frank26080115/Bones-3D-Printer/cad_exports/STL/Gcode_Hephaestus/readme.txt

These G-code files only work on my (Frank's) Hephaestus 3D printer
