frank26080115/Bones-3D-Printer/images/corexy/beltfrm3.png

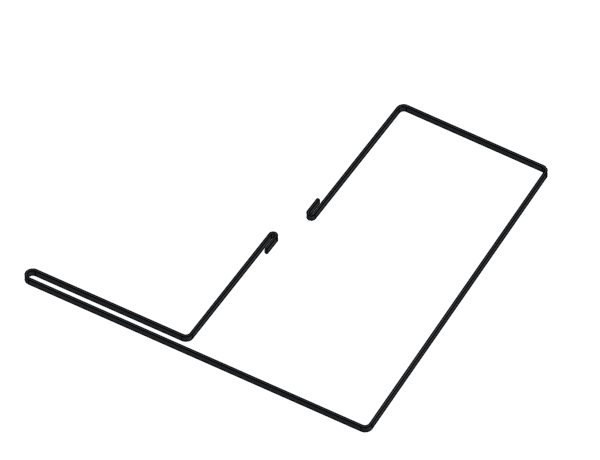
images/corexy/beltfrm3.png
