frank26080115/Bones-3D-Printer/images/corexydesignreview1.png

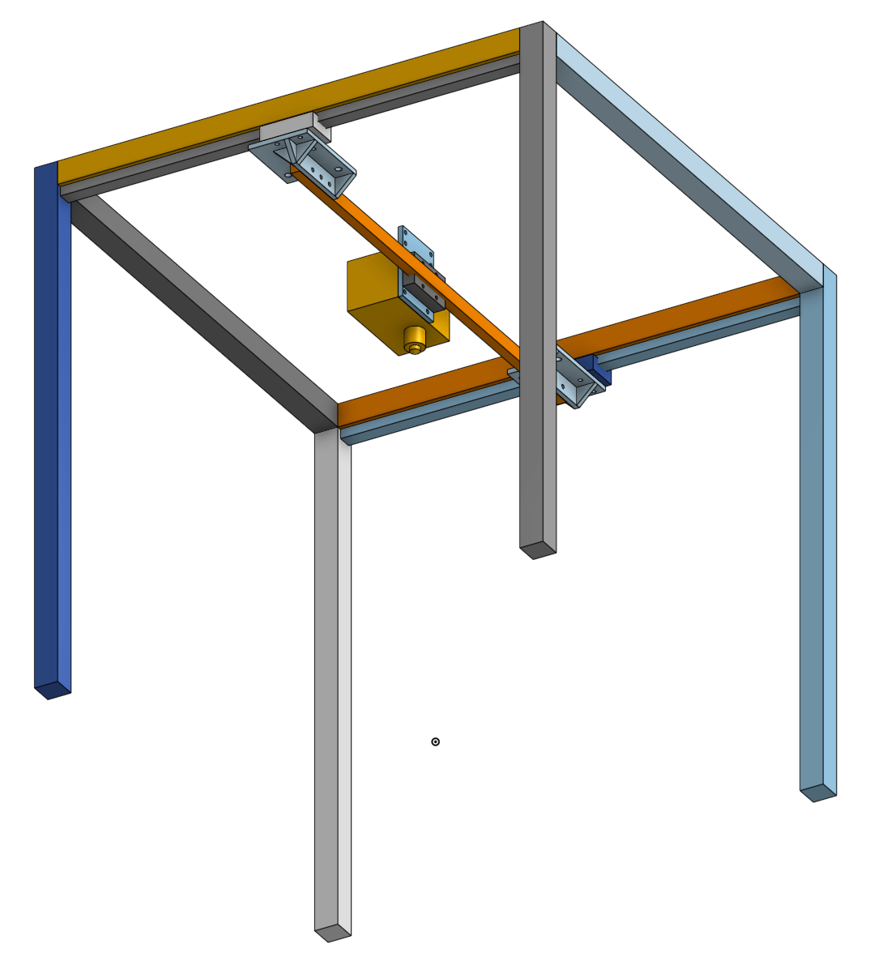
images/corexydesignreview1.png
