frank26080115/Bones-3D-Printer/images/lesson1/hbeamfrontrearmirror.png

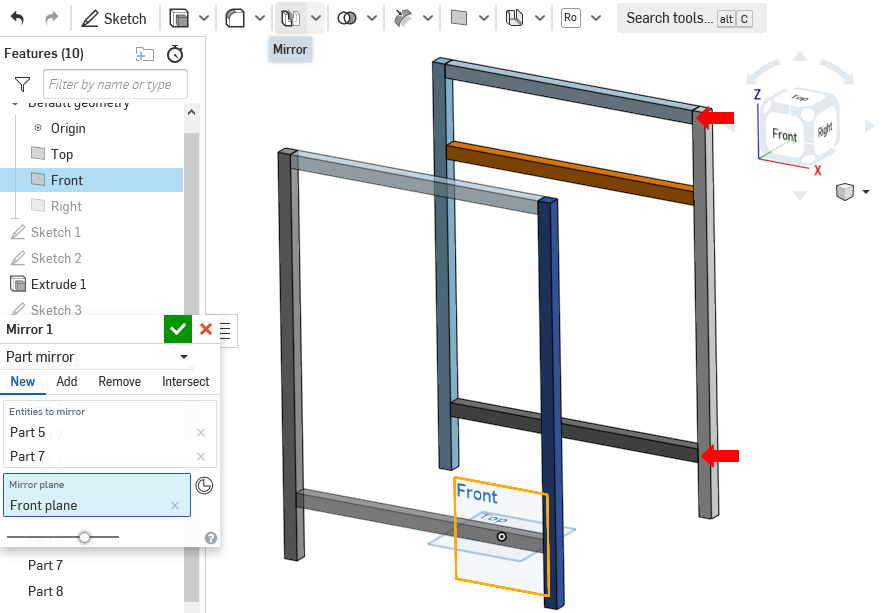
images/lesson1/hbeamfrontrearmirror.png
