frank26080115/Bones-3D-Printer/images/lesson1/zupperplanningsketches.png

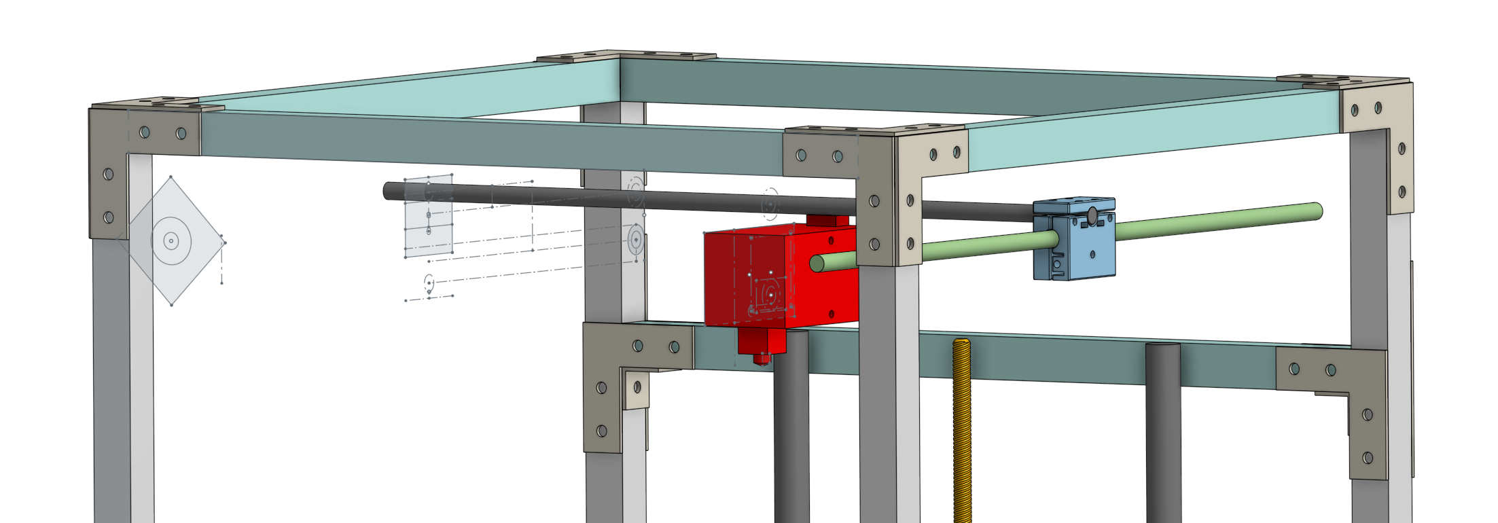
images/lesson1/zupperplanningsketches.png
