frank26080115/Bones-3D-Printer/images/lesson3/wobbleani1.png

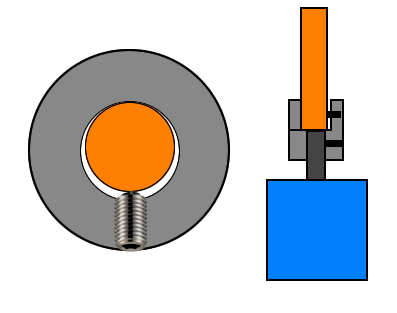
images/lesson3/wobbleani1.png
