frank26080115/Bones-3D-Printer/images/lesson5/pictures/toothedbelt.jpg

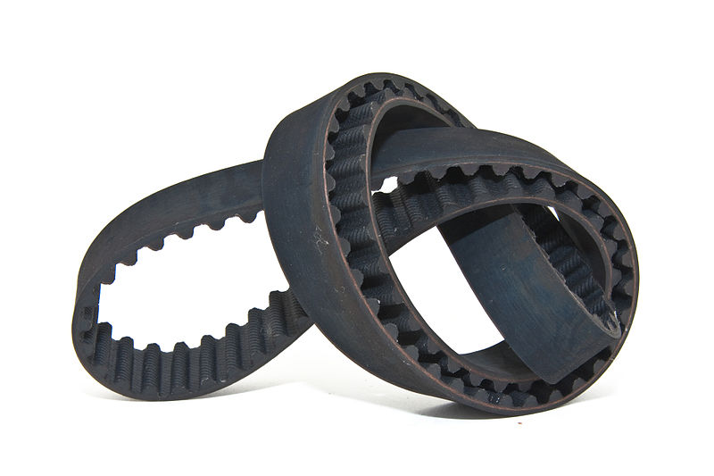
images/lesson5/pictures/toothedbelt.jpg
