frank26080115/Bones-3D-Printer/images/lesson6/powersupplyvariations.png

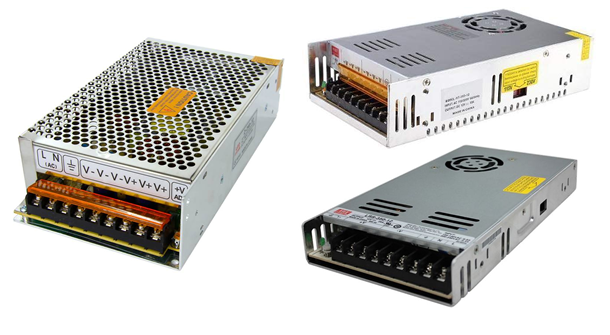
images/lesson6/powersupplyvariations.png
