frank26080115/Bones-3D-Printer/images/lesson10/extrudermountanimation/1.png

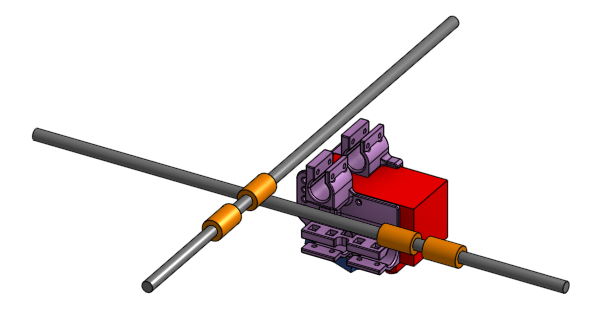
images/lesson10/extrudermountanimation/1.png
