frank26080115/Bones-3D-Printer/images/lesson10/extrudermountanimation/3.png

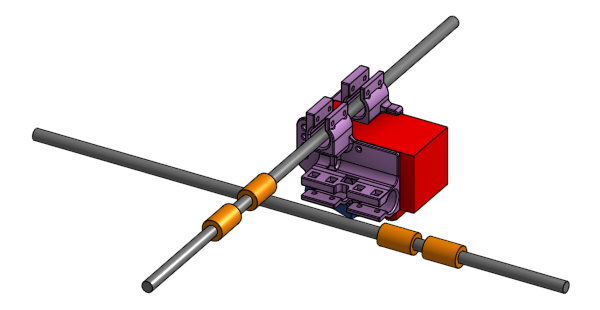
images/lesson10/extrudermountanimation/3.png
