frank26080115/Bones-3D-Printer/images/lesson10/rodsmoveanimation/2.png

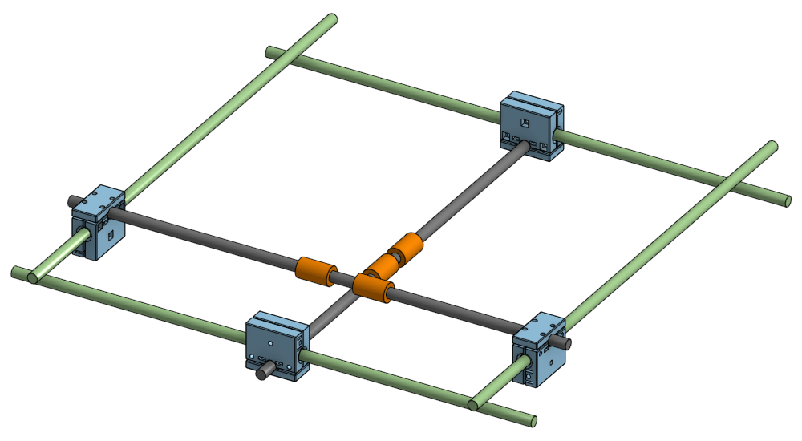
images/lesson10/rodsmoveanimation/2.png
