frank26080115/Bones-3D-Printer/images/lesson10/zaxistightenanimation/up.png

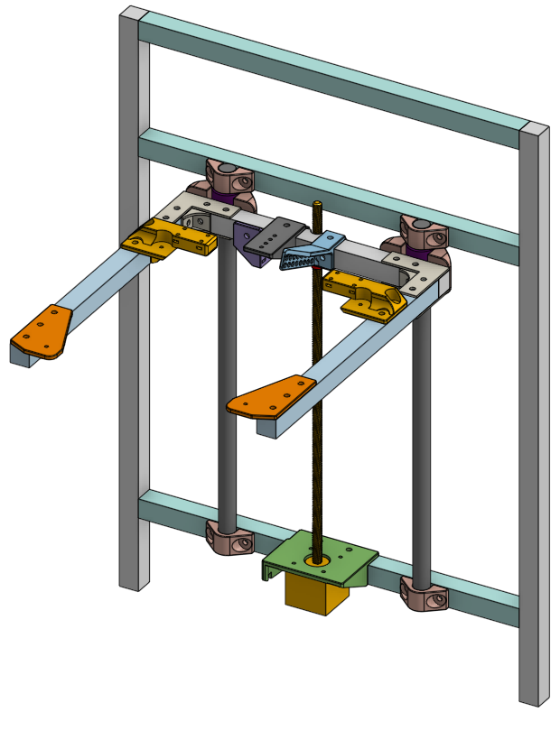
images/lesson10/zaxistightenanimation/up.png
