frank26080115/Bones-3D-Printer/images/lesson11/connectfansferrule.png

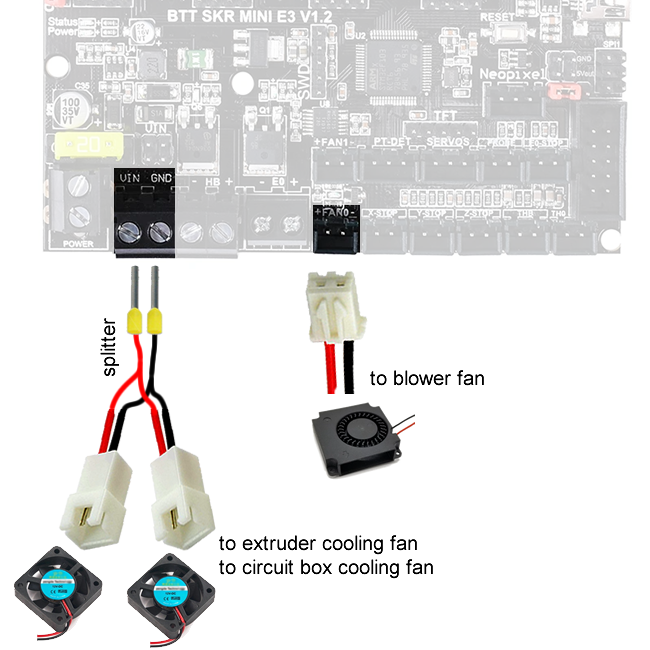
images/lesson11/connectfansferrule.png
