frank26080115/Bones-3D-Printer/images/lesson11/extruderfanextensionwireferrule.png

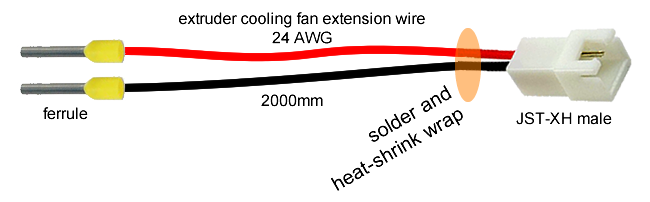
images/lesson11/extruderfanextensionwireferrule.png
