frank26080115/Bones-3D-Printer/images/lesson11/fansplitterferrule.png

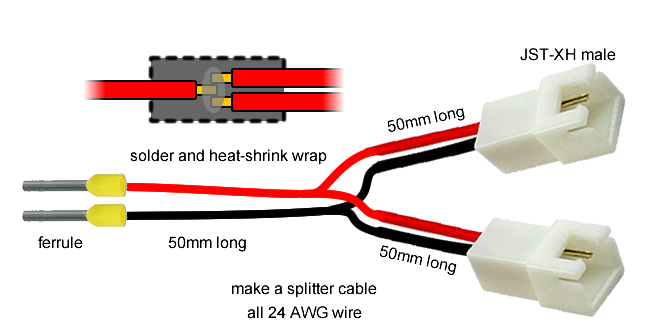
images/lesson11/fansplitterferrule.png
