frank26080115/Bones-3D-Printer/images/lesson12/fwupdateled1.png

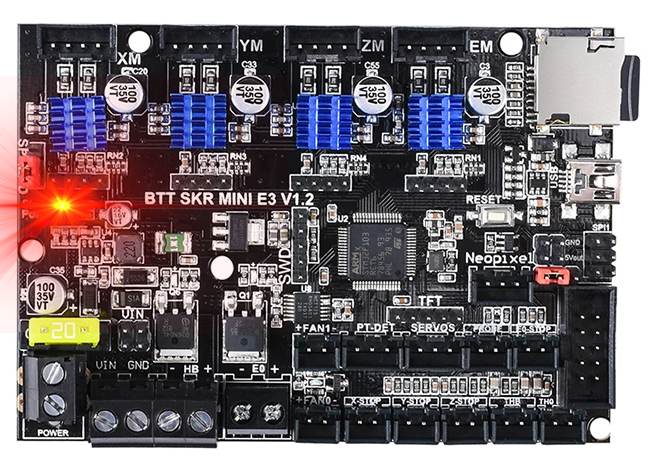
images/lesson12/fwupdateled1.png
