frank26080115/Bones-3D-Printer/images/other/freeleadscrew2.png

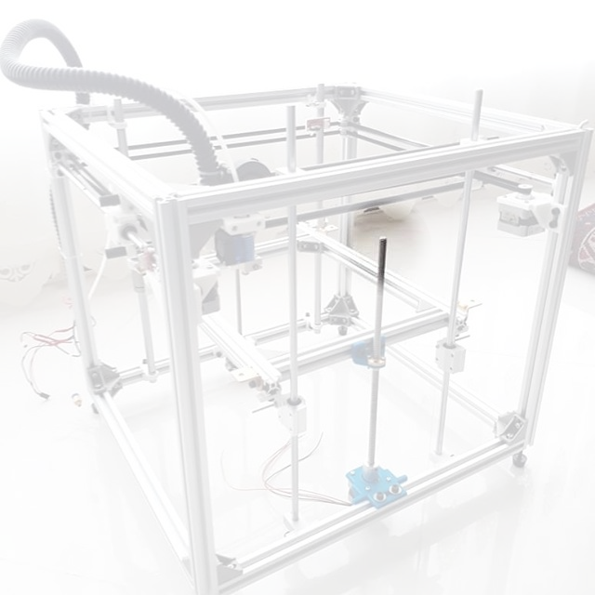
images/other/freeleadscrew2.png
