frank26080115/Bones-3D-Printer/cad_exports/Better Blower Fan Mount.step

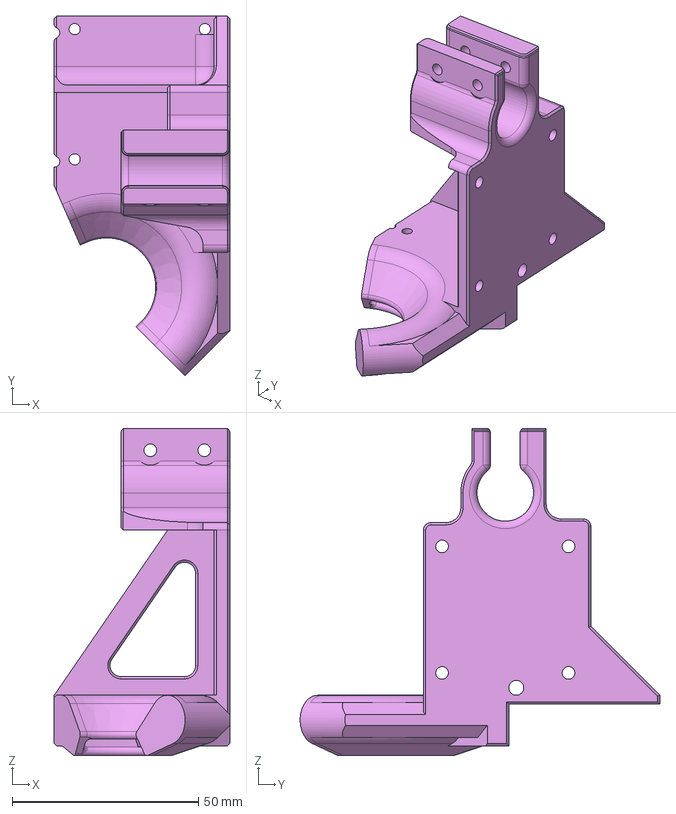
[picture p233: CAD file, 2020-03-14]
cad_exports/Better Blower Fan Mount.step
47.2 x 96.7 x 87.9 mm
