frank26080115/Bones-3D-Printer/cad_exports/STL/slidingblockouter.stl

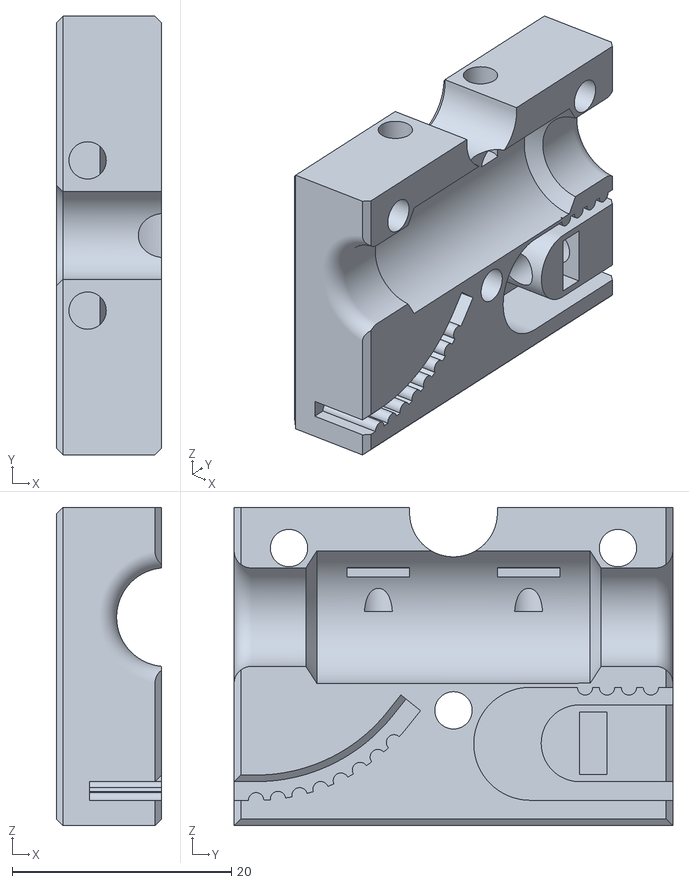
[picture p234: CAD file, 2020-03-14]
cad_exports/STL/slidingblockouter.stl
9.60 x 40.0 x 29.0
