frank26080115/Bones-3D-Printer/cad_exports/STL/psushield.stl

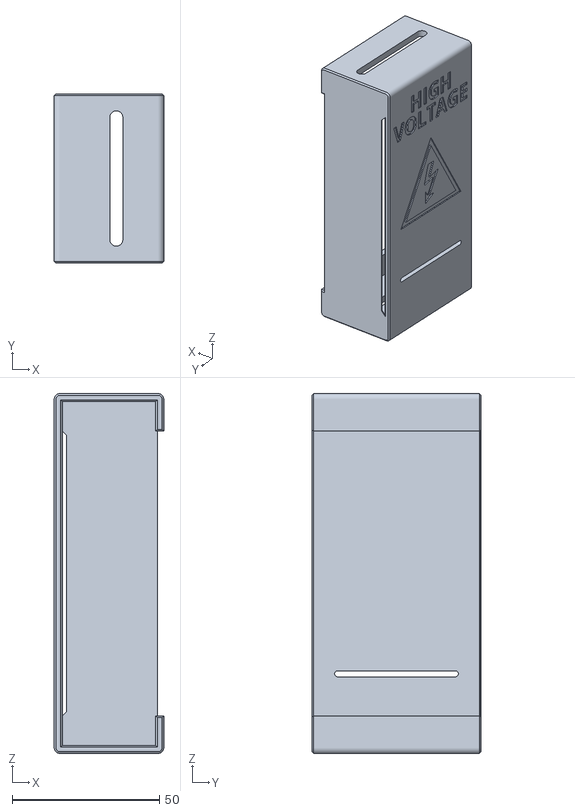
[picture p235: CAD file, 2020-03-14]
cad_exports/STL/psushield.stl
37.2 x 57.5 x 122.2
