frank26080115/Bones-3D-Printer/cad_exports/TFT24 Box Angled.step

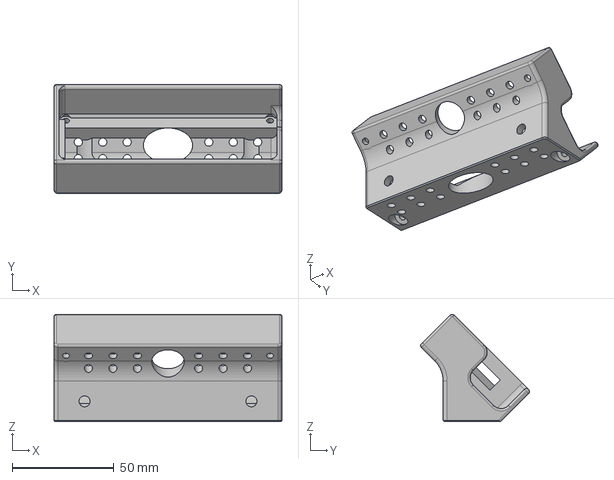
[picture p236: CAD file, 2020-03-07]
cad_exports/TFT24 Box Angled.step
111.8 x 53.4 x 52.7 mm
