frank26080115/Bones-3D-Printer/cad_exports/STL/circuitboxlid.stl

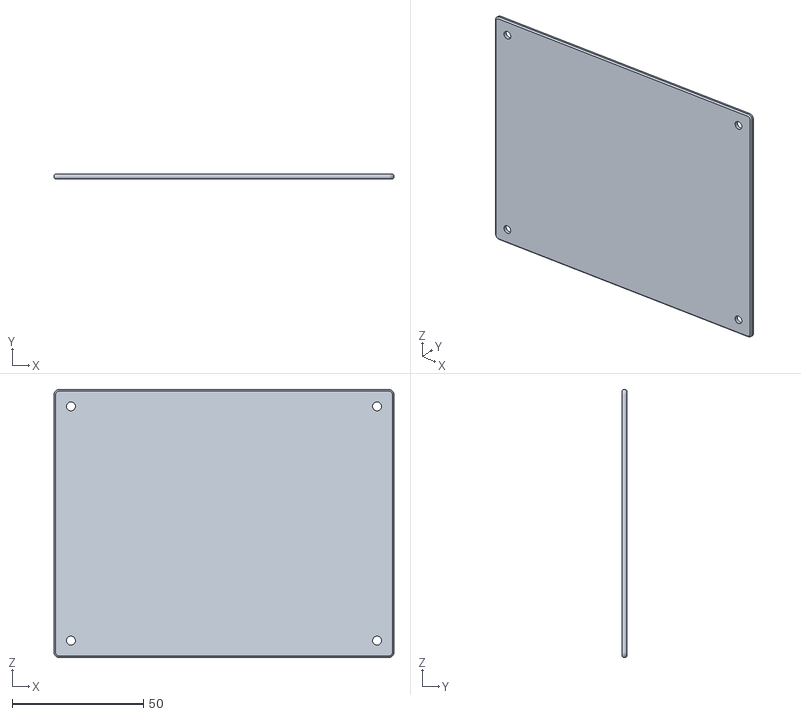
[picture p237: CAD file, 2020-03-14]
cad_exports/STL/circuitboxlid.stl
129.4 x 2.00 x 102.0
