frank26080115/Bones-3D-Printer/cad_exports/STL/box_bbtskrminie3.stl

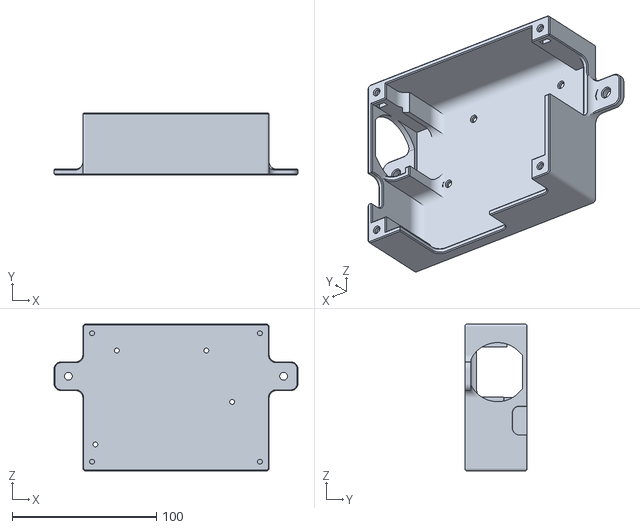
[picture p238: CAD file, 2020-03-14]
cad_exports/STL/box_bbtskrminie3.stl
169.4 x 42.8 x 102.0
