frank26080115/Bones-3D-Printer/cad_exports/STL/gantrybearingmnt_rearleft_xminlimit.stl

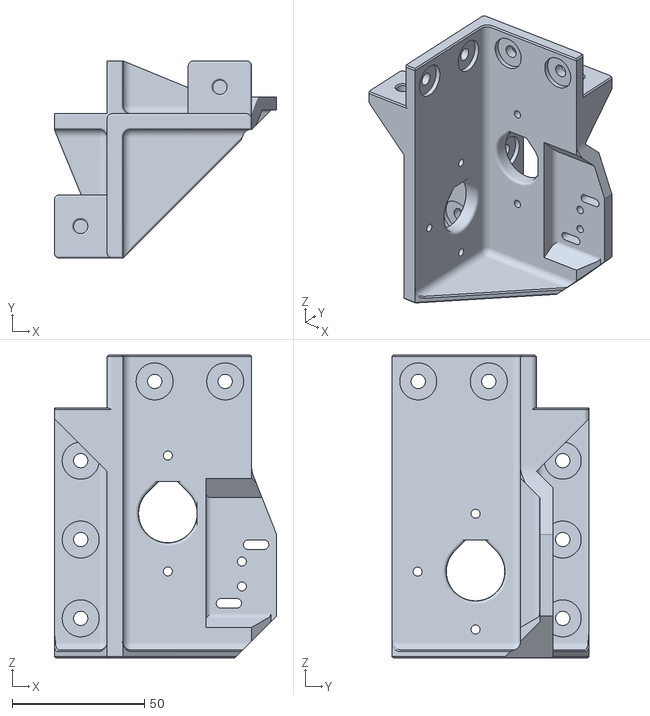
[picture p239: CAD file, 2020-03-14]
cad_exports/STL/gantrybearingmnt_rearleft_xminlimit.stl
84.2 x 74.7 x 114.7
