frank26080115/Bones-3D-Printer/cad_exports/STL/gantrybearingmnt_rearright.stl

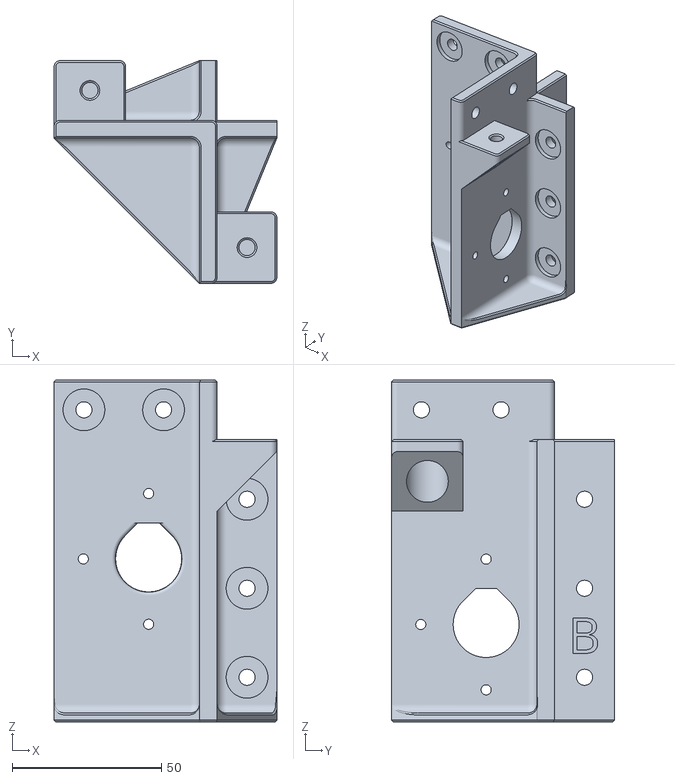
[picture p240: CAD file, 2020-03-14]
cad_exports/STL/gantrybearingmnt_rearright.stl
74.7 x 74.7 x 114.7
