frank26080115/Bones-3D-Printer/cad_exports/STL/gantrybearingmnt_frontleft_yminlimit.stl

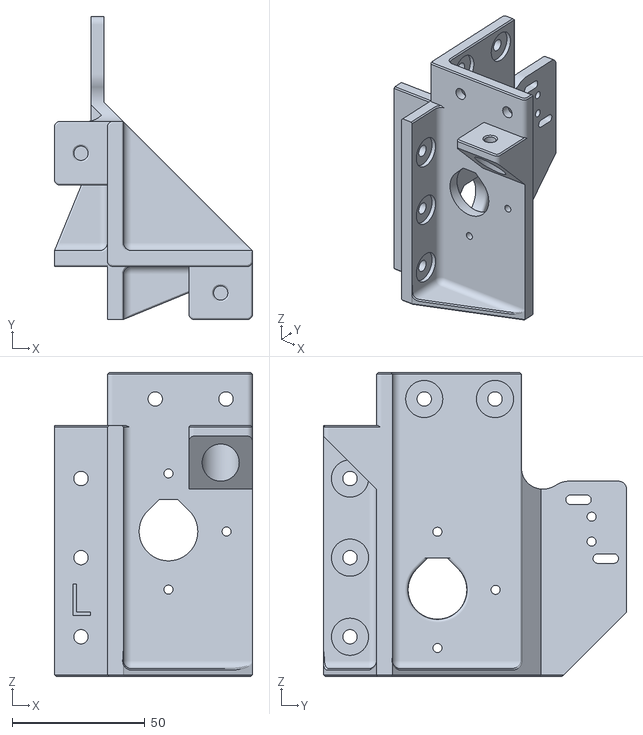
[picture p241: CAD file, 2020-03-14]
cad_exports/STL/gantrybearingmnt_frontleft_yminlimit.stl
74.7 x 114.3 x 114.7
