frank26080115/Bones-3D-Printer/cad_exports/STL/leadnutholder_cheaper.stl

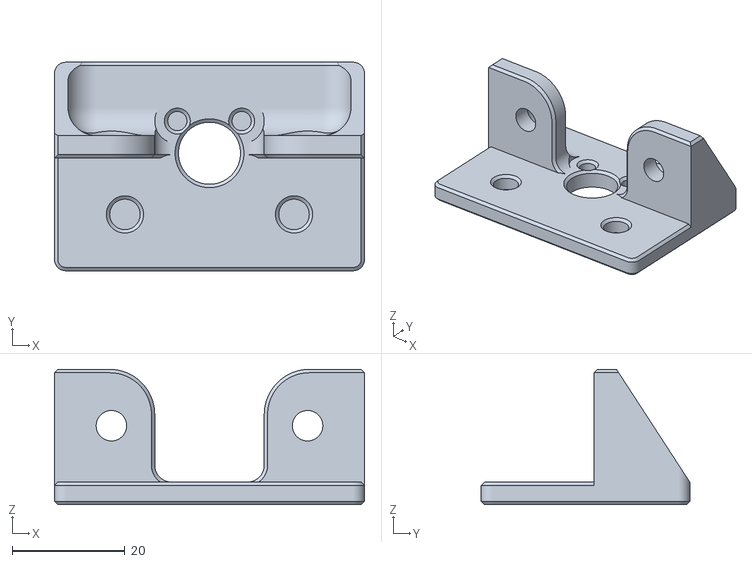
[picture p242: CAD file, 2020-03-08]
cad_exports/STL/leadnutholder_cheaper.stl
55.0 x 37.0 x 24.0
