frank26080115/Bones-3D-Printer/cad_exports/STL/acpwrpanel_4mmthick.stl

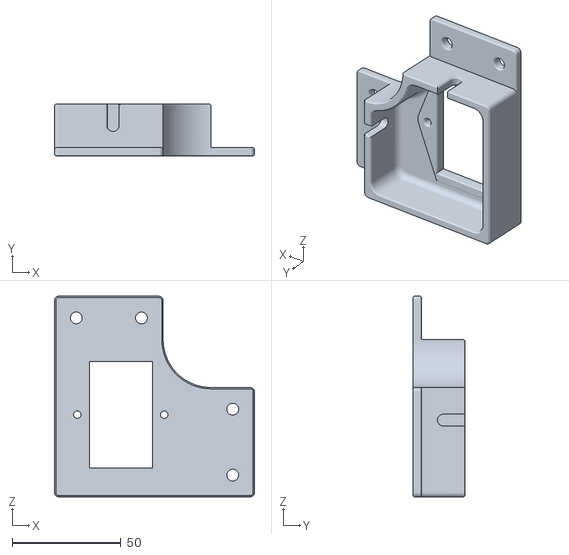
[picture p243: CAD file, 2020-03-08]
cad_exports/STL/acpwrpanel_4mmthick.stl
92.0 x 24.0 x 92.3
