frank26080115/Bones-3D-Printer/cad_exports/STL/slidingblockinner.stl

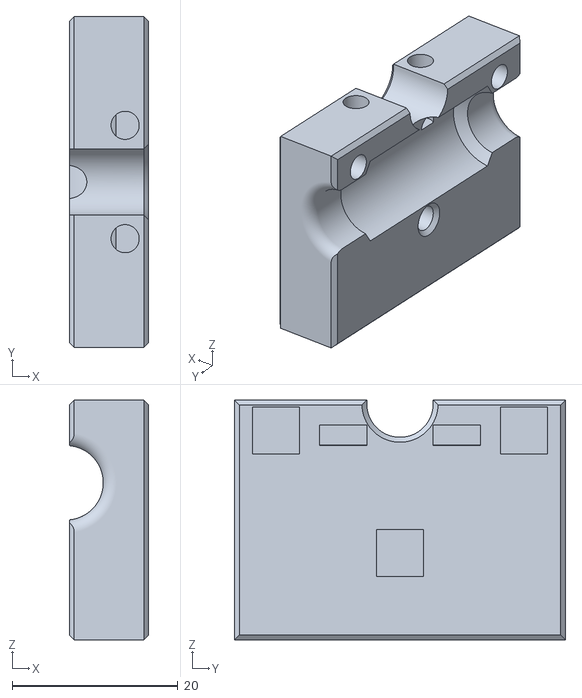
[picture p244: CAD file, 2020-03-08]
cad_exports/STL/slidingblockinner.stl
9.60 x 40.0 x 29.0
