frank26080115/Bones-3D-Printer/cad_exports/STL/zmotorholder.stl

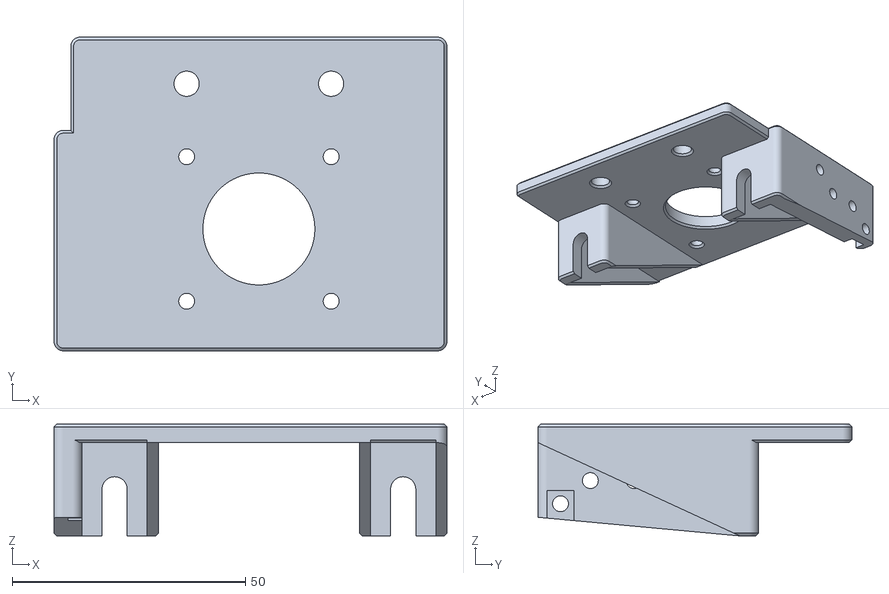
[picture p245: CAD file, 2020-03-07]
cad_exports/STL/zmotorholder.stl
84.3 x 67.3 x 24.0
