frank26080115/Bones-3D-Printer/cad_exports/STL/acpwrpanelshield.stl

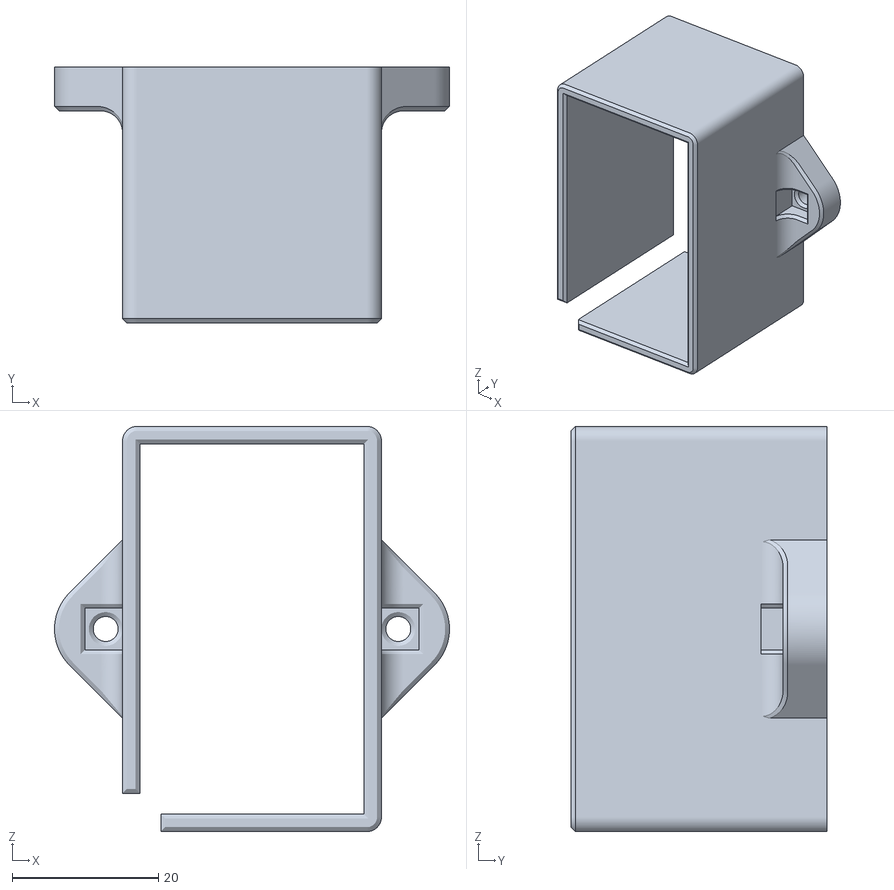
[picture p246: CAD file, 2020-03-07]
cad_exports/STL/acpwrpanelshield.stl
54.0 x 35.0 x 55.4
