frank26080115/Bones-3D-Printer/cad_exports/STL/bedcableanchor.stl

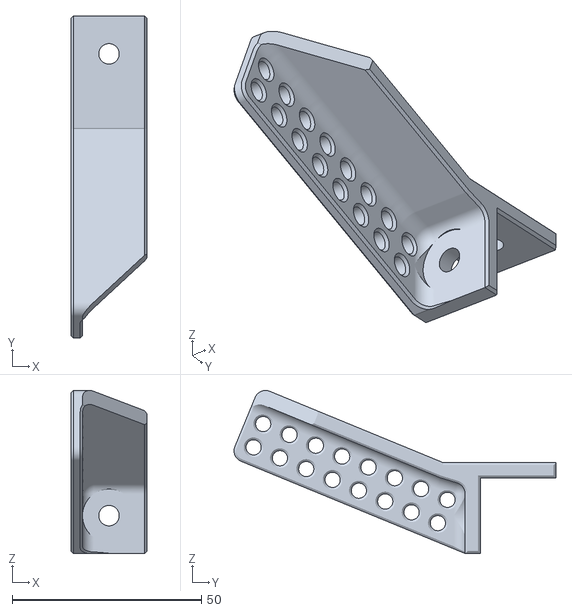
[picture p247: CAD file, 2020-03-07]
cad_exports/STL/bedcableanchor.stl
20.0 x 85.1 x 43.1
