frank26080115/Bones-3D-Printer/cad_exports/STL/acpwrpanel_2mmthick.stl

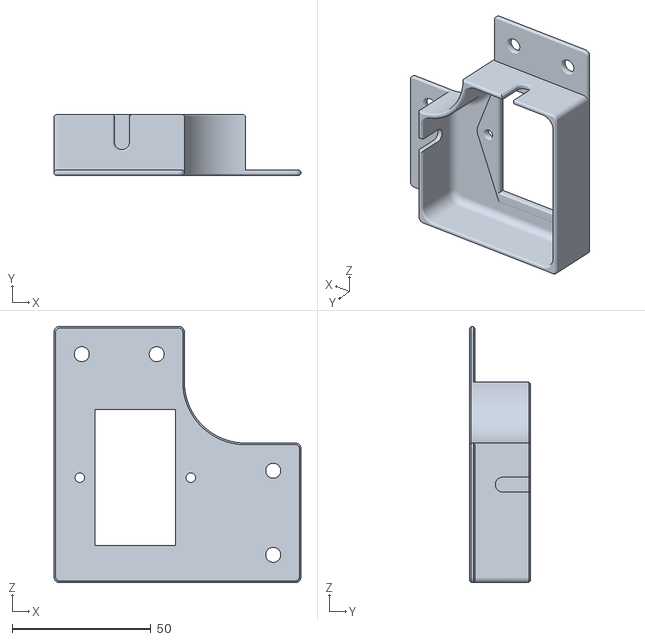
[picture p248: CAD file, 2020-03-07]
cad_exports/STL/acpwrpanel_2mmthick.stl
89.0 x 22.0 x 92.3
