frank26080115/Bones-3D-Printer/cad_exports/STL/bedstand_rearright_16mmtall.stl

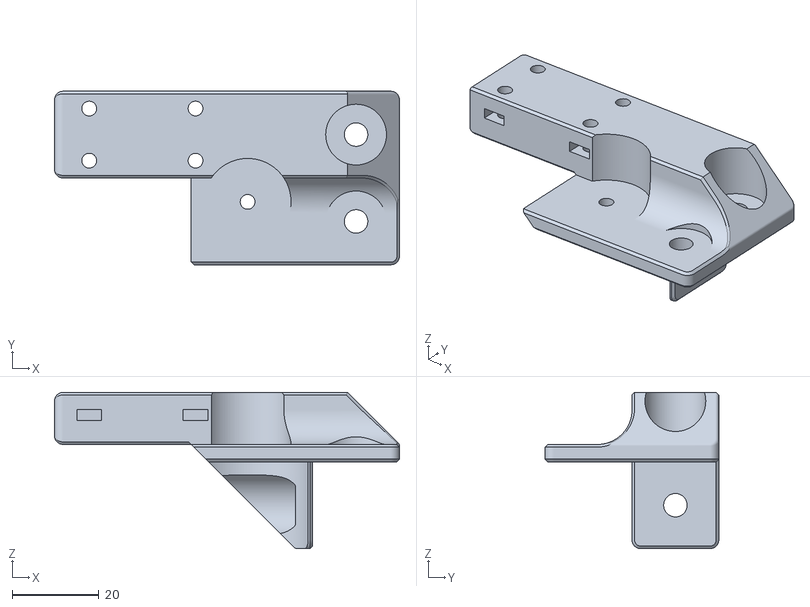
[picture p249: CAD file, 2020-03-07]
cad_exports/STL/bedstand_rearright_16mmtall.stl
79.5 x 40.0 x 36.0
