frank26080115/Bones-3D-Printer/cad_exports/STL/psumount.stl

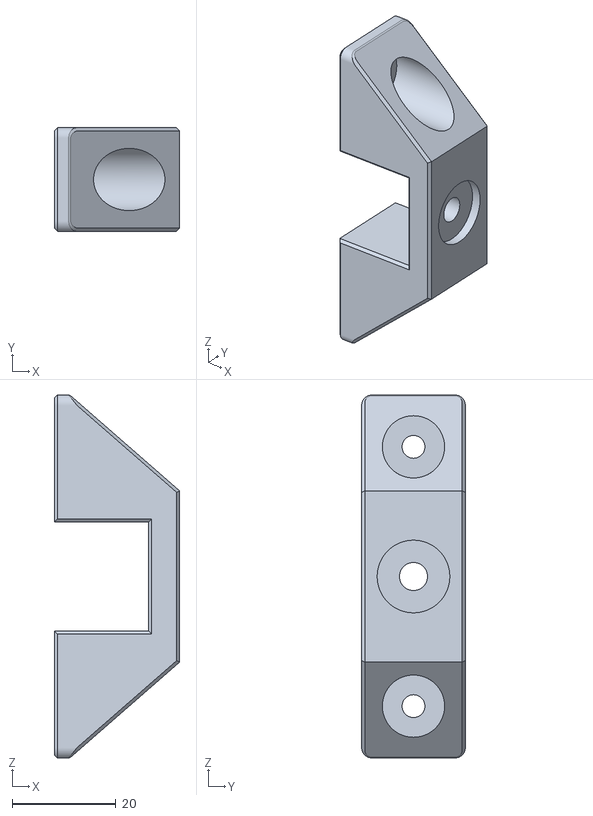
[picture p250: CAD file, 2020-03-07]
cad_exports/STL/psumount.stl
24.2 x 20.0 x 70.0
