frank26080115/Bones-3D-Printer/cad_exports/STL/slidingblocklid.stl

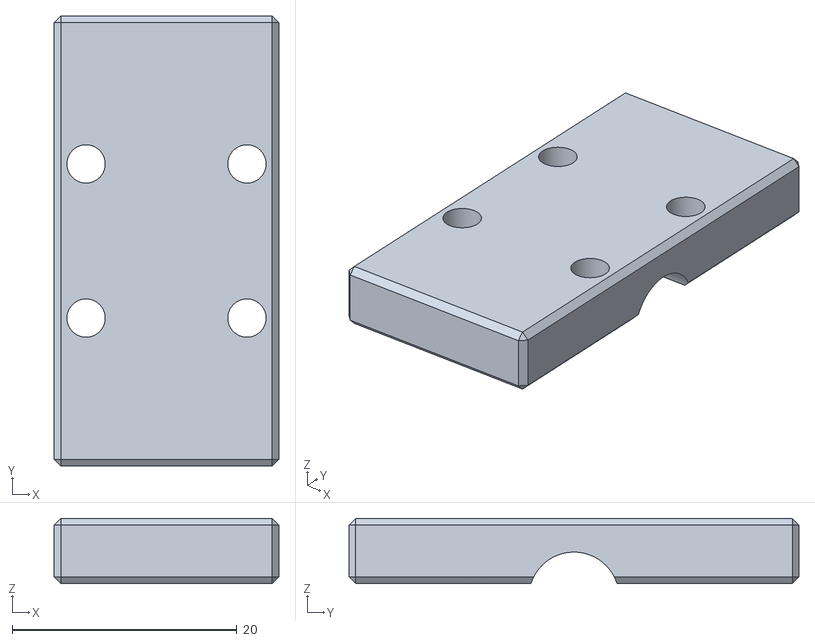
[picture p251: CAD file, 2020-03-07]
cad_exports/STL/slidingblocklid.stl
20.0 x 40.0 x 5.80
