frank26080115/Bones-3D-Printer/cad_exports/STL/zrodholder_16mmdia_0p8mmgap.stl

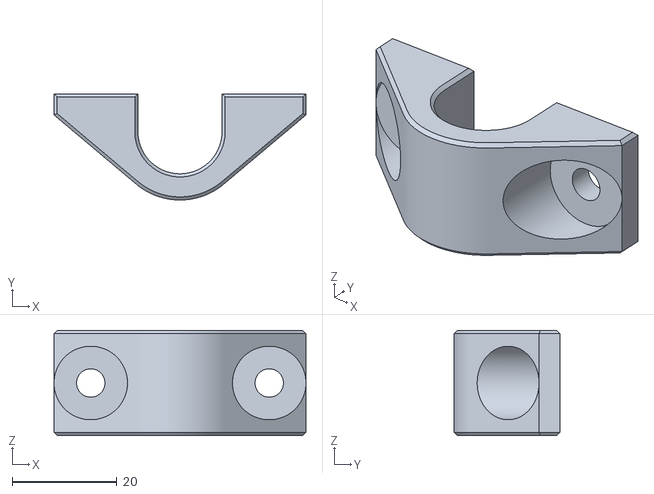
[picture p252: CAD file, 2020-03-07]
cad_exports/STL/zrodholder_16mmdia_0p8mmgap.stl
48.0 x 20.2 x 20.0
