frank26080115/Bones-3D-Printer/cad_exports/STL/zlimitactuator_28mmtall.stl

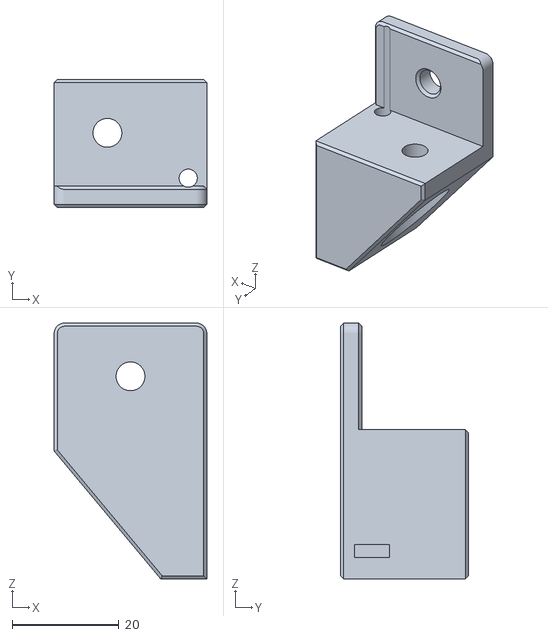
[picture p253: CAD file, 2020-03-07]
cad_exports/STL/zlimitactuator_28mmtall.stl
28.6 x 24.0 x 48.0
