frank26080115/Bones-3D-Printer/cad_exports/STL/stepperstandoff_39mm.stl

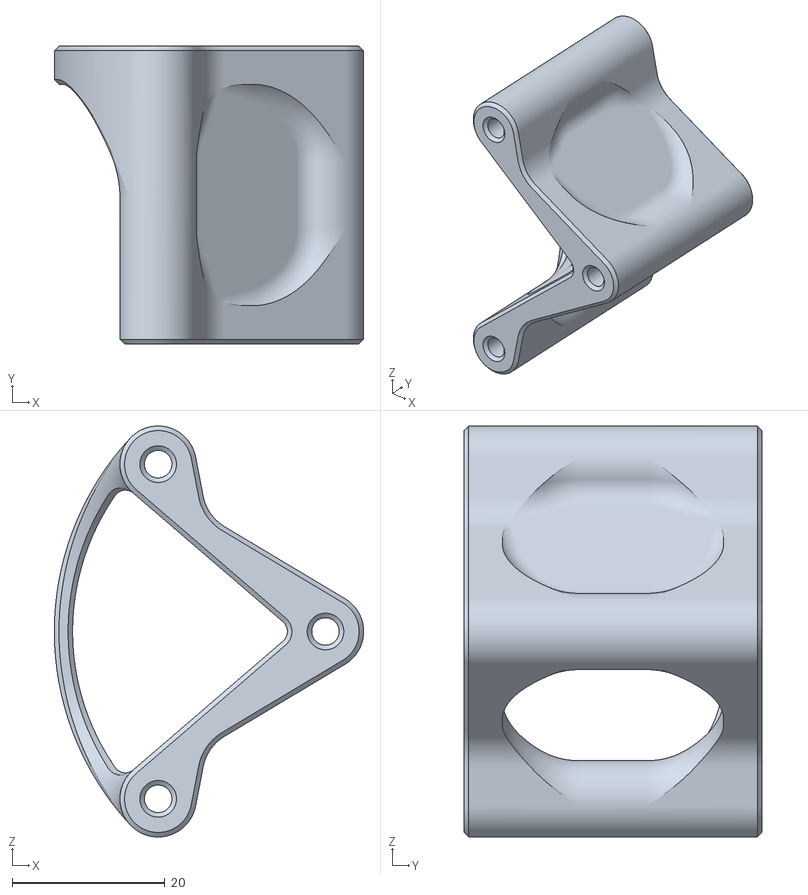
[picture p254: CAD file, 2020-03-07]
cad_exports/STL/stepperstandoff_39mm.stl
40.5 x 39.0 x 53.8
