frank26080115/Bones-3D-Printer/cad_exports/STL/bedstand_frontright.stl

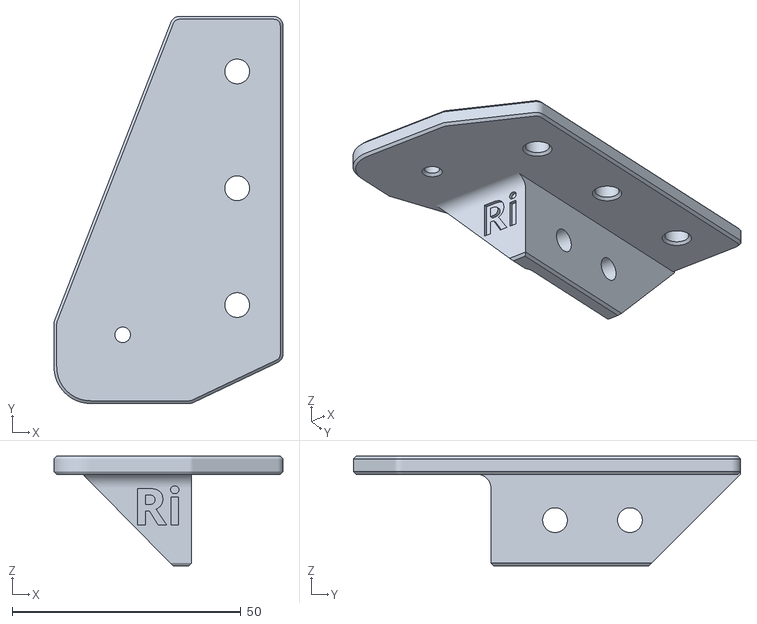
[picture p255: CAD file, 2020-03-07]
cad_exports/STL/bedstand_frontright.stl
50.0 x 84.5 x 24.0
