frank26080115/Bones-3D-Printer/cad_exports/STL/zbearingholder_24mmdia_0p8mmgap.stl

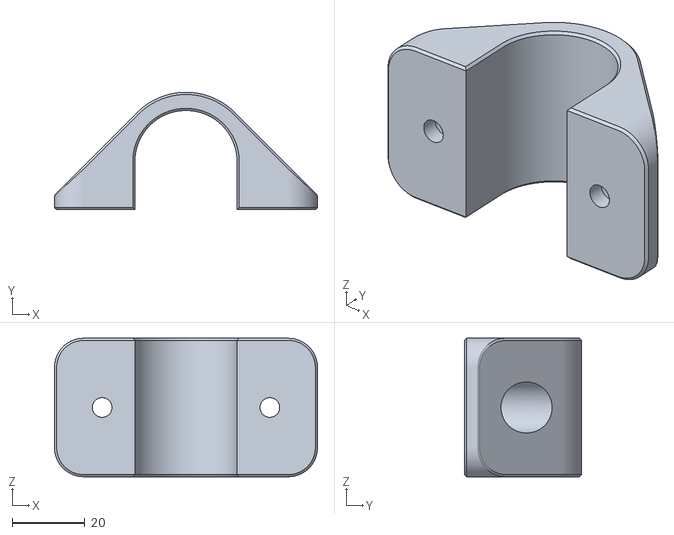
[picture p256: CAD file, 2020-03-07]
cad_exports/STL/zbearingholder_24mmdia_0p8mmgap.stl
72.1 x 32.2 x 38.0
