frank26080115/Bones-3D-Printer/cad_exports/STL/dragchainanchor.stl

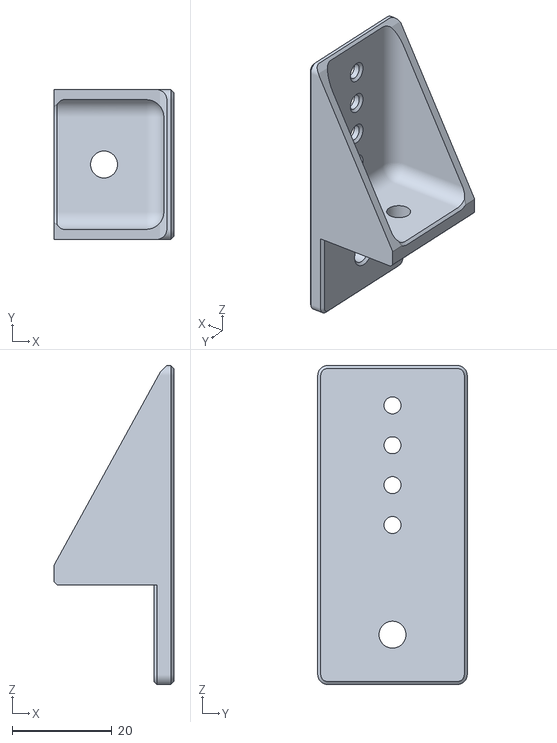
[picture p257: CAD file, 2020-03-07]
cad_exports/STL/dragchainanchor.stl
24.0 x 30.0 x 64.0
