frank26080115/Bones-3D-Printer/(list of files, cad)

Other CAD files:
cad_exports/STL/gantrybearingmnt_frontright.stl
cad_exports/STL/tft24box_angled_v2.stl
cad_exports/STL/leadnutholder_countersunk.stl
cad_exports/STL/bedstand_rearleft_16mmtall.stl
cad_exports/STL/bedstand_frontleft.stl
cad_exports/STL/leadscrewupperguard.stl
