frank26080115/Bones-3D-Printer/images/lesson10/bedforkassembly.png

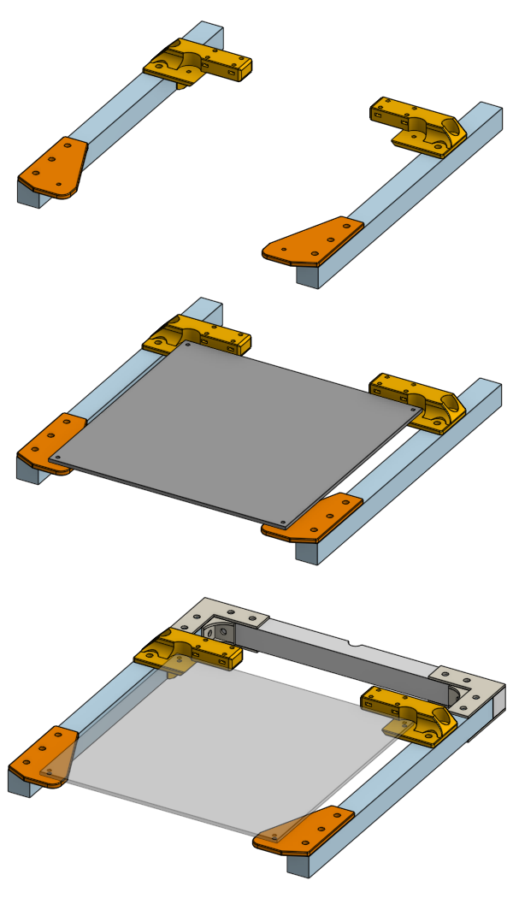
images/lesson10/bedforkassembly.png
