frank26080115/Bones-3D-Printer/marlin_files/Configuration.h

#pragma once
#define CONFIGURATION_H_VERSION 020000
#define STRING_CONFIG_H_AUTHOR "Frank Zhao" // Who made the changes.
#define SERIAL_PORT 2 // Changed for Bones, need 2, one for USB, one for the LCD
#define SERIAL_PORT_2 -1 // Changed for Bones, -1 means USB
#define BAUDRATE 115200 // Changed for Bones, LCD expects this baudrate
  #define MOTHERBOARD BOARD_BTT_SKR_MINI_E3_V1_2 // Changed for Bones, we are using the BTT SKR Mini E3
#define CUSTOM_MACHINE_NAME "Bones" // Changed for Bones
#define MACHINE_UUID "6fffa9ae-4976-11ea-b77f-2e728ce88125" // Changed for Bones
#define EXTRUDERS 1
#define DEFAULT_NOMINAL_FILAMENT_DIA 1.75 // Changed for Bones
#define TEMP_SENSOR_0 5 // Changed for Bones, E3D's thermistor cartridge uses Semitec 104GT-2
#define TEMP_SENSOR_1 0
#define TEMP_SENSOR_2 0
#define TEMP_SENSOR_3 0
#define TEMP_SENSOR_4 0
#define TEMP_SENSOR_5 0
#define TEMP_SENSOR_6 0
#define TEMP_SENSOR_7 0
#define TEMP_SENSOR_BED 5 // Changed for Bones, Anet's bed uses Semitec
#define TEMP_SENSOR_PROBE 0
#define TEMP_SENSOR_CHAMBER 0
#define DUMMY_THERMISTOR_998_VALUE 25
#define DUMMY_THERMISTOR_999_VALUE 100
#define MAX_REDUNDANT_TEMP_SENSOR_DIFF 10
#define TEMP_RESIDENCY_TIME     10  // (seconds) Time to wait for hotend to "settle" in M109
#define TEMP_WINDOW              1  // (°C) Temperature proximity for the "temperature reached" timer
#define TEMP_HYSTERESIS          3  // (°C) Temperature proximity considered "close enough" to the target
#define TEMP_BED_RESIDENCY_TIME 10  // (seconds) Time to wait for bed to "settle" in M190
#define TEMP_BED_WINDOW          1  // (°C) Temperature proximity for the "temperature reached" timer
#define TEMP_BED_HYSTERESIS      3  // (°C) Temperature proximity considered "close enough" to the target
#define HEATER_0_MINTEMP   5
#define HEATER_1_MINTEMP   5
#define HEATER_2_MINTEMP   5
#define HEATER_3_MINTEMP   5
#define HEATER_4_MINTEMP   5
#define HEATER_5_MINTEMP   5
#define HEATER_6_MINTEMP   5
#define HEATER_7_MINTEMP   5
#define BED_MINTEMP        5
#define HEATER_0_MAXTEMP 300 // Changed for Bones
#define HEATER_1_MAXTEMP 275
#define HEATER_2_MAXTEMP 275
#define HEATER_3_MAXTEMP 275
#define HEATER_4_MAXTEMP 275
#define HEATER_5_MAXTEMP 275
#define HEATER_6_MAXTEMP 275
#define HEATER_7_MAXTEMP 275
#define BED_MAXTEMP      125 // Changed for Bones
#define PIDTEMP
#define BANG_MAX 255     // Limits current to nozzle while in bang-bang mode; 255=full current
#define PID_MAX BANG_MAX // Limits current to nozzle while PID is active (see PID_FUNCTIONAL_RANGE below); 255=full current
#define PID_K1 0.95      // Smoothing factor within any PID loop
  #define PID_EDIT_MENU         // Add PID editing to the "Advanced Settings" menu. (~700 bytes of PROGMEM)      // Enabled for Bones
  #define PID_AUTOTUNE_MENU     // Add PID auto-tuning to the "Advanced Settings" menu. (~250 bytes of PROGMEM)  // Enabled for Bones
  #define PID_FUNCTIONAL_RANGE 10 // If the temperature difference between the target temperature and the actual temperature
  #define  DEFAULT_Kp 29.20
  #define  DEFAULT_Ki  4.73
  #define  DEFAULT_Kd 45.33
#define MAX_BED_POWER 255 // limits duty cycle to bed; 255=full current
#define PREVENT_COLD_EXTRUSION
#define EXTRUDE_MINTEMP 170
#define PREVENT_LENGTHY_EXTRUDE
#define EXTRUDE_MAXLENGTH 200
#define THERMAL_PROTECTION_HOTENDS // Enable thermal protection for all extruders       // for Bones, this is enabled
#define THERMAL_PROTECTION_BED     // Enable thermal protection for the heated bed      // for Bones, this is enabled
#define THERMAL_PROTECTION_CHAMBER // Enable thermal protection for the heated chamber
#define USE_XMIN_PLUG   // Enabled for Bones
#define USE_YMIN_PLUG   // Enabled for Bones
#define USE_ZMAX_PLUG // Enabled for Bones
#define ENDSTOPPULLUPS
#define X_MIN_ENDSTOP_INVERTING false // Set to true to invert the logic of the endstop.
#define Y_MIN_ENDSTOP_INVERTING false // Set to true to invert the logic of the endstop.
#define Z_MIN_ENDSTOP_INVERTING false // Set to true to invert the logic of the endstop.
#define X_MAX_ENDSTOP_INVERTING false // Set to true to invert the logic of the endstop.
#define Y_MAX_ENDSTOP_INVERTING false // Set to true to invert the logic of the endstop.
#define Z_MAX_ENDSTOP_INVERTING false // Set to true to invert the logic of the endstop.
#define Z_MIN_PROBE_ENDSTOP_INVERTING false // Set to true to invert the logic of the probe.
#define X_DRIVER_TYPE  TMC2209 // Changed for Bones
#define Y_DRIVER_TYPE  TMC2209 // Changed for Bones
#define Z_DRIVER_TYPE  TMC2209 // Changed for Bones
#define E0_DRIVER_TYPE TMC2209 // Changed for Bones
#define DEFAULT_AXIS_STEPS_PER_UNIT   { 80, 80, 25, 408 } // Changed for Bones
#define DEFAULT_MAX_FEEDRATE          { 300, 300, 5, 25 } // Double-check for Bones
#define DEFAULT_MAX_ACCELERATION      { 3000, 3000, 100, 10000 } // TODO for Bones
#define DEFAULT_ACCELERATION          3000    // X, Y, Z and E acceleration for printing moves // TODO for Bones
#define DEFAULT_RETRACT_ACCELERATION  3000    // E acceleration for retracts // TODO for Bones
#define DEFAULT_TRAVEL_ACCELERATION   3000    // X, Y, Z acceleration for travel (non printing) moves // TODO for Bones
#define DEFAULT_EJERK    5.0  // May be used by Linear Advance // TODO for Bones
  #define JUNCTION_DEVIATION_MM 0.013 // (mm) Distance from real junction edge
#define S_CURVE_ACCELERATION  // Enabled for Bones
#define Z_MIN_PROBE_USES_Z_MIN_ENDSTOP_PIN
#define PROBE_MANUALLY  // Enabled for Bones, we will not have a probe
#define NOZZLE_TO_PROBE_OFFSET { 10, 10, 0 }
#define MIN_PROBE_EDGE 10
#define XY_PROBE_SPEED 8000
#define Z_PROBE_SPEED_FAST HOMING_FEEDRATE_Z
#define Z_PROBE_SPEED_SLOW (Z_PROBE_SPEED_FAST / 2)
#define Z_CLEARANCE_DEPLOY_PROBE   10 // Z Clearance for Deploy/Stow
#define Z_CLEARANCE_BETWEEN_PROBES  5 // Z Clearance between probe points
#define Z_CLEARANCE_MULTI_PROBE     5 // Z Clearance between multiple probes
#define Z_PROBE_LOW_POINT          -2 // Farthest distance below the trigger-point to go before stopping
#define Z_PROBE_OFFSET_RANGE_MIN -20
#define Z_PROBE_OFFSET_RANGE_MAX 20
#define X_ENABLE_ON 0
#define Y_ENABLE_ON 0
#define Z_ENABLE_ON 0
#define E_ENABLE_ON 0 // For all extruders
#define DISABLE_X false
#define DISABLE_Y false
#define DISABLE_Z false
#define DISABLE_E false             // For all extruders
#define DISABLE_INACTIVE_EXTRUDER   // Keep only the active extruder enabled
#define INVERT_X_DIR false // TODO for Bones, must be double checked by testing
#define INVERT_Y_DIR false // TODO for Bones, must be double checked by testing
#define INVERT_Z_DIR false // TODO for Bones, must be double checked by testing
#define INVERT_E0_DIR false // TODO for Bones, must be double checked by testing
#define INVERT_E1_DIR false
#define INVERT_E2_DIR false
#define INVERT_E3_DIR false
#define INVERT_E4_DIR false
#define INVERT_E5_DIR false
#define INVERT_E6_DIR false
#define INVERT_E7_DIR false
#define Z_HOMING_HEIGHT 10  // (mm) Minimal Z height before homing (G28) for Z clearance above the bed, clamps, ... // Changed for Bones
#define X_HOME_DIR -1 // Changed for Bones, -1 means the X axis limit switch is on the left, and the homing will move the print head towards the left
#define Y_HOME_DIR -1 // Changed for Bones, -1 means the Y axis limit switch is towards the front, and the homing will move the print head towards the front (aka you)
#define Z_HOME_DIR 1  // Changed for Bones, 1 means the bed's limit switch is at the bottom, and homing will move the bed towards the bottom
#define X_BED_SIZE 220 // Changed for Bones, we are using a 220 x 220 mm bed
#define Y_BED_SIZE 220 // Changed for Bones, we are using a 220 x 220 mm bed
#define X_MIN_POS 0
#define Y_MIN_POS 0
#define Z_MIN_POS 0
#define X_MAX_POS X_BED_SIZE
#define Y_MAX_POS Y_BED_SIZE
#define Z_MAX_POS 300 // Changed for Bones, this is the "height" of the printable volume, may be tweaked later
#define MIN_SOFTWARE_ENDSTOPS
  #define MIN_SOFTWARE_ENDSTOP_X
  #define MIN_SOFTWARE_ENDSTOP_Y
  #define MIN_SOFTWARE_ENDSTOP_Z
#define MAX_SOFTWARE_ENDSTOPS
  #define MAX_SOFTWARE_ENDSTOP_X
  #define MAX_SOFTWARE_ENDSTOP_Y
  #define MAX_SOFTWARE_ENDSTOP_Z
#define AUTO_BED_LEVELING_3POINT  // Enabled for Bones, but done without a probe, see "PROBE_MANUALLY"
#define LCD_BED_LEVELING    // Enabled for Bones
  #define MESH_EDIT_Z_STEP  0.04  // (mm) Step size while manually probing Z axis. // Changed for Bones, leadscrew pitch and step size taken into account
  #define LCD_PROBE_Z_RANGE 4     // (mm) Z Range centered on Z_MIN_POS for LCD Z adjustment
#define LEVEL_BED_CORNERS    // Changed for Bones
  #define LEVEL_CORNERS_INSET 30    // (mm) An inset for corner leveling
  #define LEVEL_CORNERS_Z_HOP  4.0  // (mm) Move nozzle up before moving between corners
  #define LEVEL_CORNERS_HEIGHT 0.0  // (mm) Z height of nozzle at leveling points
#define HOMING_FEEDRATE_XY (50*60) // Double-check for Bones
#define HOMING_FEEDRATE_Z  (4*60)  // Double-check for Bones
#define VALIDATE_HOMING_ENDSTOPS
#define EEPROM_SETTINGS     // Persistent storage with M500 and M501    // Enabled for Bones, of couse we need non-volatile storage
#define EEPROM_CHITCHAT       // Give feedback on EEPROM commands. Disable to save PROGMEM.
#define HOST_KEEPALIVE_FEATURE        // Disable this if your host doesn't like keepalive messages
#define DEFAULT_KEEPALIVE_INTERVAL 2  // Number of seconds between "busy" messages. Set with M113.
#define BUSY_WHILE_HEATING            // Some hosts require "busy" messages even during heating
#define PREHEAT_1_LABEL       "PLA"
#define PREHEAT_1_TEMP_HOTEND 180 // Double-check for Bones, actual temperature will be set from slicer
#define PREHEAT_1_TEMP_BED     70 // Double-check for Bones, actual temperature will be set from slicer
#define PREHEAT_1_FAN_SPEED     0 // Value from 0 to 255, fan will be controlled by slicer
#define PREHEAT_2_LABEL       "PETG" // Double-check for Bones
#define PREHEAT_2_TEMP_HOTEND 240    // Double-check for Bones, actual temperature will be set from slicer
#define PREHEAT_2_TEMP_BED     70    // Double-check for Bones, actual temperature will be set from slicer
#define PREHEAT_2_FAN_SPEED     0    // Value from 0 to 255, fan will be controlled by slicer
#define PRINTJOB_TIMER_AUTOSTART
#define LCD_LANGUAGE en
#define LCD_INFO_SCREEN_STYLE 0
#define SDSUPPORT    // Enabled for Bones, of course we want this enabled
#define SD_CHECK_AND_RETRY    // Enabled for Bones, of course we want this enabled
#define INDIVIDUAL_AXIS_HOMING_MENU    // Optional for Bones
#define CR10_STOCKDISPLAY // Selected for Bones, this one is the one that BIGTREETECH should be compatible with
#define SOFT_PWM_SCALE 0
#define SERVO_DELAY { 300 }
