frank26080115/Bones-3D-Printer/marlin_files/Configuration_adv.h

#define E0_AUTO_FAN_PIN -1
#define E1_AUTO_FAN_PIN -1
#define E2_AUTO_FAN_PIN -1
#define E3_AUTO_FAN_PIN -1
#define E4_AUTO_FAN_PIN -1
#define E5_AUTO_FAN_PIN -1
#define CHAMBER_AUTO_FAN_PIN -1
#define X_HOME_BUMP_MM 5
#define Y_HOME_BUMP_MM 5
#define Z_HOME_BUMP_MM 2
#define HOMING_BUMP_DIVISOR { 2, 2, 4 }  // Re-Bump Speed Divisor (Divides the Homing Feedrate)
#define QUICK_HOME                       // If homing includes X and Y, do a diagonal move initially // Optional for Bones, because it's faster
#define MICROSTEP_MODES { 16, 16, 16, 16, 16, 16 } // [1,2,4,8,16]
#define DIGIPOT_I2C_MOTOR_CURRENTS { 1.0, 1.0, 1.0, 1.0, 1.0, 1.0, 1.0, 1.0 }  //  AZTEEG_X3_PRO
#define LIN_ADVANCE  // Optional for Bones, but K set to 0, tune later
  #define LIN_ADVANCE_K 0.22    // Unit: mm compression per 1mm/s extruder speed  // Enabled for Bones, but K set to 0, tune later
    #define X_CURRENT       800        // (mA) RMS current. Multiply by 1.414 for peak current. // EDIT for Bones
    #define X_CURRENT_HOME  X_CURRENT  // (mA) RMS current for sensorless homing
    #define X_MICROSTEPS     16    // 0..256
    #define Y_CURRENT       800 // EDIT for Bones
    #define Y_CURRENT_HOME  Y_CURRENT
    #define Y_MICROSTEPS     16
    #define Z_CURRENT       800 // EDIT for Bones
    #define Z_CURRENT_HOME  Z_CURRENT
    #define Z_MICROSTEPS      1 // Changed for Bones, disabled, check DEFAULT_AXIS_STEPS_PER_UNIT
    #define E0_CURRENT      800 // EDIT for Bones
    #define E0_MICROSTEPS    16
    #define CURRENT_STEP_DOWN     50  // [mA]
    #define REPORT_CURRENT_CHANGE
  #define HYBRID_THRESHOLD  // Enabled for Bones
  #define X_HYBRID_THRESHOLD     100  // [mm/s]
  #define X2_HYBRID_THRESHOLD    100
  #define Y_HYBRID_THRESHOLD     100
  #define Y2_HYBRID_THRESHOLD    100
  #define Z_HYBRID_THRESHOLD       3
  #define Z2_HYBRID_THRESHOLD      3
  #define Z3_HYBRID_THRESHOLD      3
  #define Z4_HYBRID_THRESHOLD      3
  #define E0_HYBRID_THRESHOLD     30
  #define E1_HYBRID_THRESHOLD     30
  #define E2_HYBRID_THRESHOLD     30
  #define E3_HYBRID_THRESHOLD     30
  #define E4_HYBRID_THRESHOLD     30
  #define E5_HYBRID_THRESHOLD     30
  #define E6_HYBRID_THRESHOLD     30
  #define E7_HYBRID_THRESHOLD     30
