frank26080115/Bones-3D-Printer/(commit log)

2020-02-14 igus bearing picture
2020-02-18 added external mosfet to lesson8
2020-02-18 belt tensioning
2020-02-19 drag chain, binder clips, 3d printed feet
2020-02-19 tube guide anchor
2020-02-19 a bunch of assembly images
2020-02-20 assembly instructions work in progress
2020-02-21 progress on assembly instructions
2020-02-22 all lessons at least exists now
    [Configuration.h, Configuration_adv.h]
2020-02-22 update file links
    [Configuration.h, Configuration_adv.h]
2020-02-22 minor edits, added LCD connection picture
    [Configuration_adv.h]
2020-02-23 lcd connection and grounding pictures
2020-02-23 added twisted wire and cross talk info
2020-02-23 adding STEP files
    [Better Blower Fan Mount.step, TFT24 Box Angled.step]
2020-02-24 external mosfet
2020-02-24 links to wikipedia on external mosfet page
2020-02-25 additional infor about stepper current and temperature calibration
2020-02-26 corexy belt planning, linked to by index page
2020-02-28 info on Z axis wobble
2020-02-29 gantry motion test and adjustment
2020-02-29 rear bed block redesign
2020-02-29 clarification on wiring limit switch
2020-03-03 added note about printing GBM with consistency
2020-03-03 added section on sensorless homing
2020-03-05 updated CAD model
2020-03-07 note about 16mm rod pricing
2020-03-07 cad model update
    [TFT24 Box Angled.step, acpwrpanel.stl, acpwrpanelshield.stl, bedcableanchor.stl, bedstand_frontleft.stl, bedstand_frontright.stl, bedstand_rearleft_16mmtall.stl, bedstand_rearright_16mmtall.stl]
2020-03-08 cad and gcode update
    [Better Blower Fan Mount.step, acpwrpanel.stl, acpwrpanel_2mmthick.stl, acpwrpanel_4mmthick.stl, circuitboxlid.stl, gantrybearingmnt_frontleft_yminlimit.stl, gantrybearingmnt_frontright.stl, gantrybearingmnt_rearleft_xminlimit.stl]
2020-03-08 more hemera mount thickness variation STLs
2020-03-10 changed thickness of hemera mount
    [Better Blower Fan Mount.step]
2020-03-10 update tft24 box for better print
    [tft24box_angled_v2.stl]
2020-03-10 lubrication, Z axis alignment
2020-03-10 zmotorholder printed in pairs to avoid overheating the small tops
2020-03-11 added power cord to buy list
2020-03-11 faster printing for GBM
2020-03-12 psu shield prints better with more foothold
    [psushield.stl]
2020-03-14 model updated with improvements found during printing
2020-03-14 fixed wrong air intake dimensions, realized after fitting the fan
    [Better Blower Fan Mount.step]
2020-03-14 gbm added a taper to the bearing hole
    [gantrybearingmnt_frontleft_yminlimit.stl, gantrybearingmnt_frontright.stl, gantrybearingmnt_rearleft_xminlimit.stl, gantrybearingmnt_rearright.stl]
2020-03-14 circuit box thicker for better print quality
    [box_bbtskrminie3.stl, circuitboxlid.stl]
2020-03-14 PSU shield easier printing with thermal relief and bottom
    [psushield.stl]
2020-03-14 tighter belt holding groove for sliding block
    [slidingblockouter.stl]
